CharelF01/CREPO2/Fotos/IMG_20220616_120403.jpg

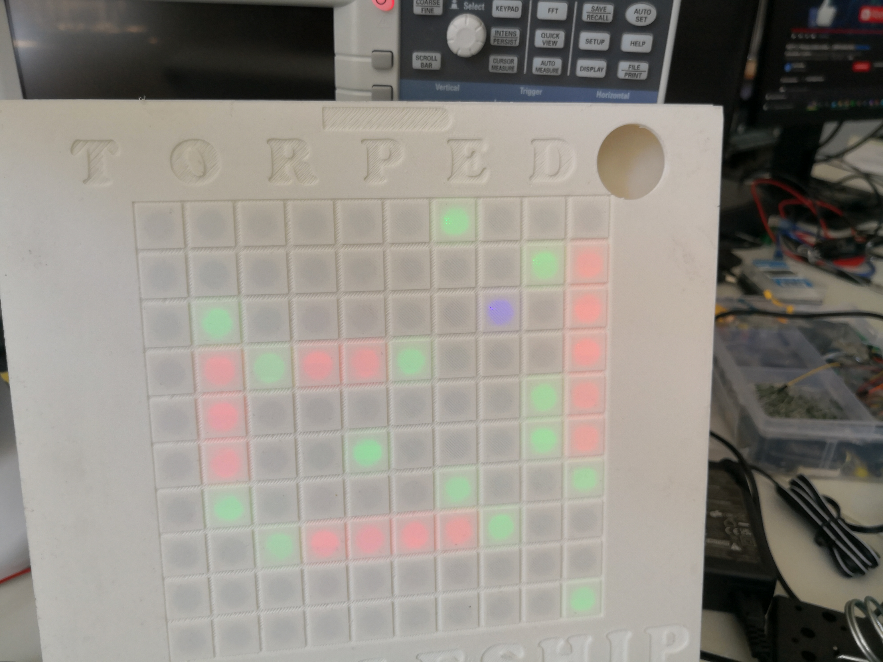
Fotos/IMG_20220616_120403.jpg
