CharelF01/CREPO2/README.md

# CREPO2
This project was done in the scope of the BTS-Internet of Things in the Lycée des Arts et Métiers Luxembourg
The Creative Project 2's objective was to smartify a boardgame, I chose Battleship

Mark received on Project: 14.6/20
