CharelF01/CREPO2/Documentation/Render.JPG

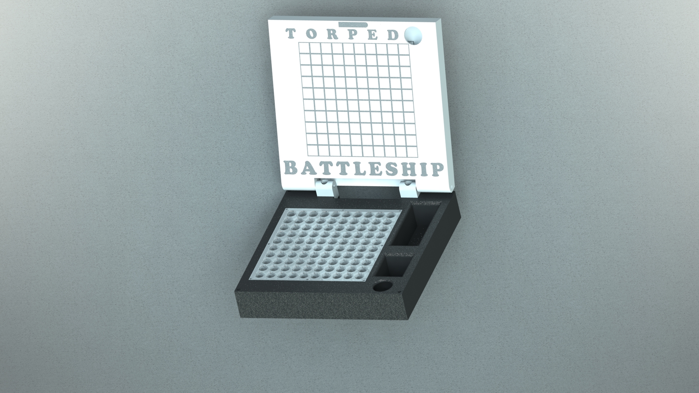
Documentation/Render.JPG
