CharelF01/CREPO2/Fotos/IMG_20220614_172337.jpg

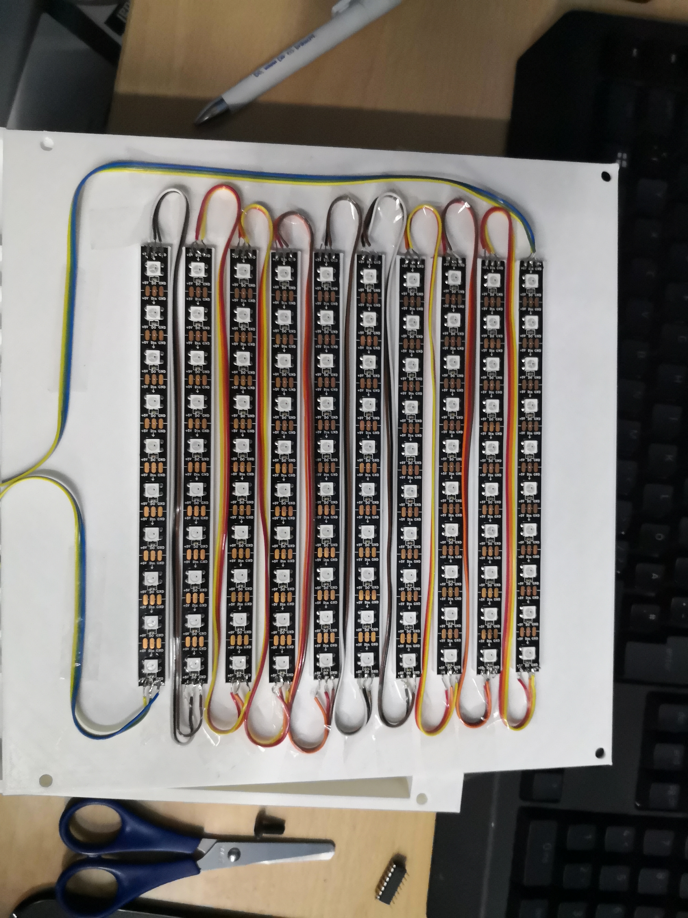
Fotos/IMG_20220614_172337.jpg
