CharelF01/CREPO2/Fotos/IMG_20220614_172339.jpg

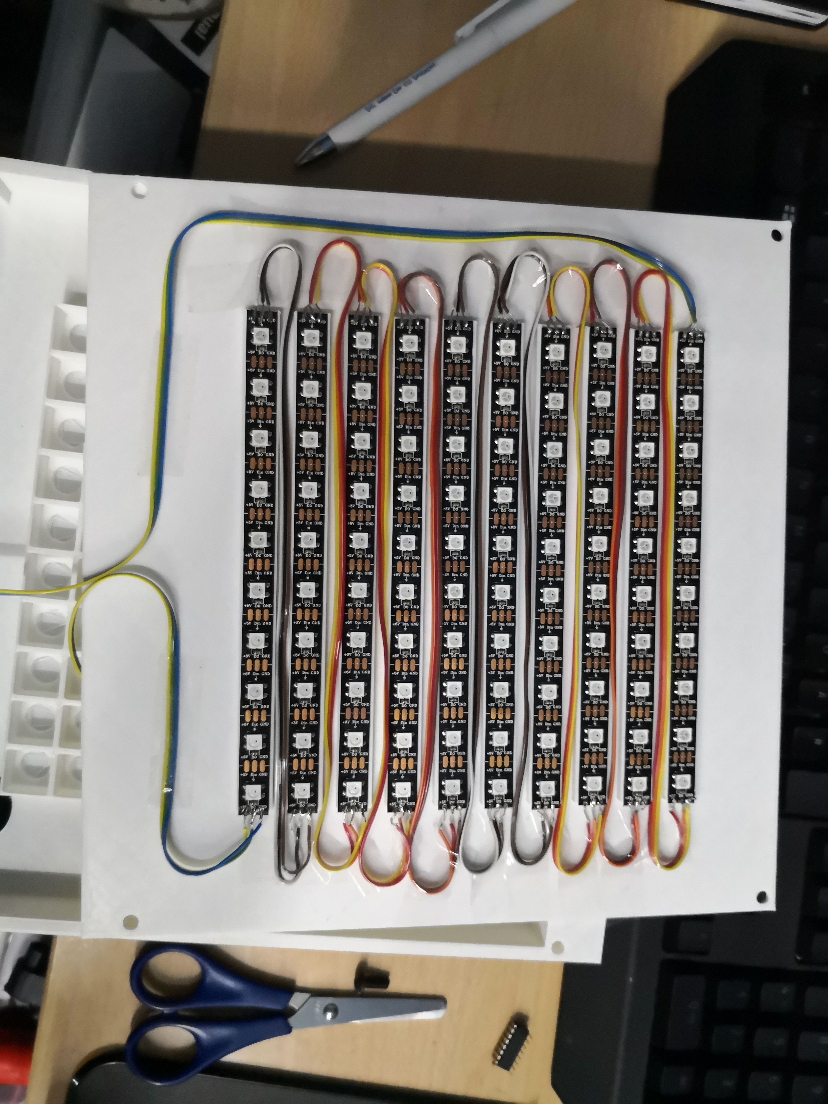
Fotos/IMG_20220614_172339.jpg
