CharelF01/CREPO2/Fotos/IMG_20220615_181046.jpg

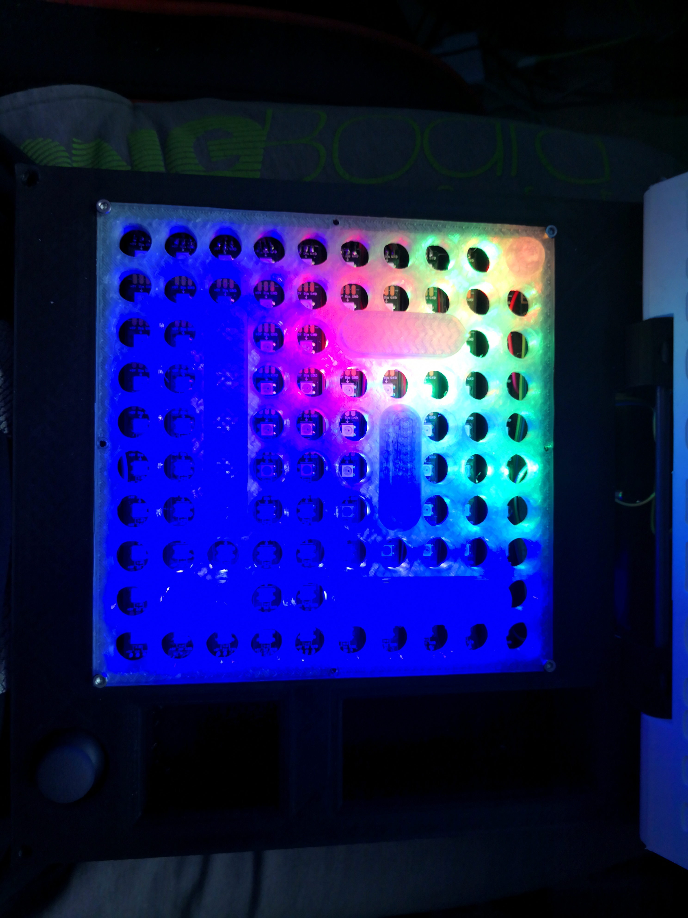
Fotos/IMG_20220615_181046.jpg
