CharelF01/CREPO2/Fotos/IMG_20220621_085531.jpg

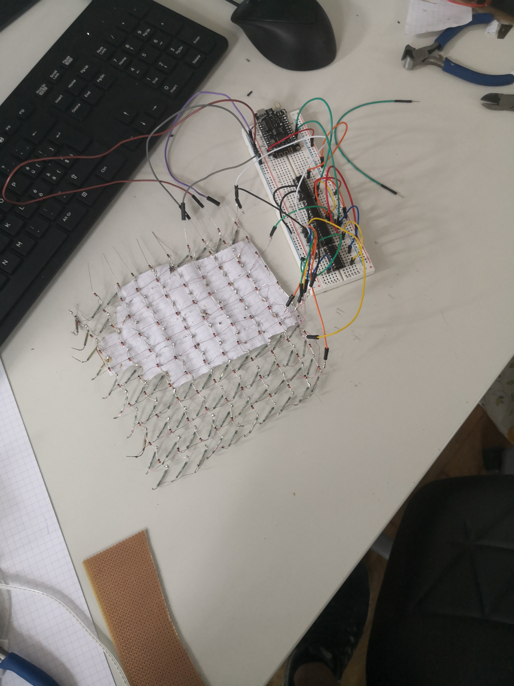
Fotos/IMG_20220621_085531.jpg
