CharelF01/CREPO2/Fotos/IMG_20220621_105107.jpg

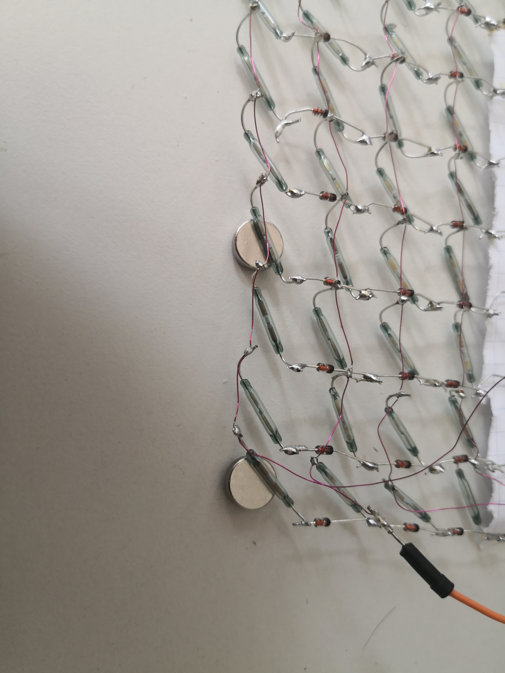
Fotos/IMG_20220621_105107.jpg
