CharelF01/CREPO2/Fotos/IMG_20220623_173132.jpg

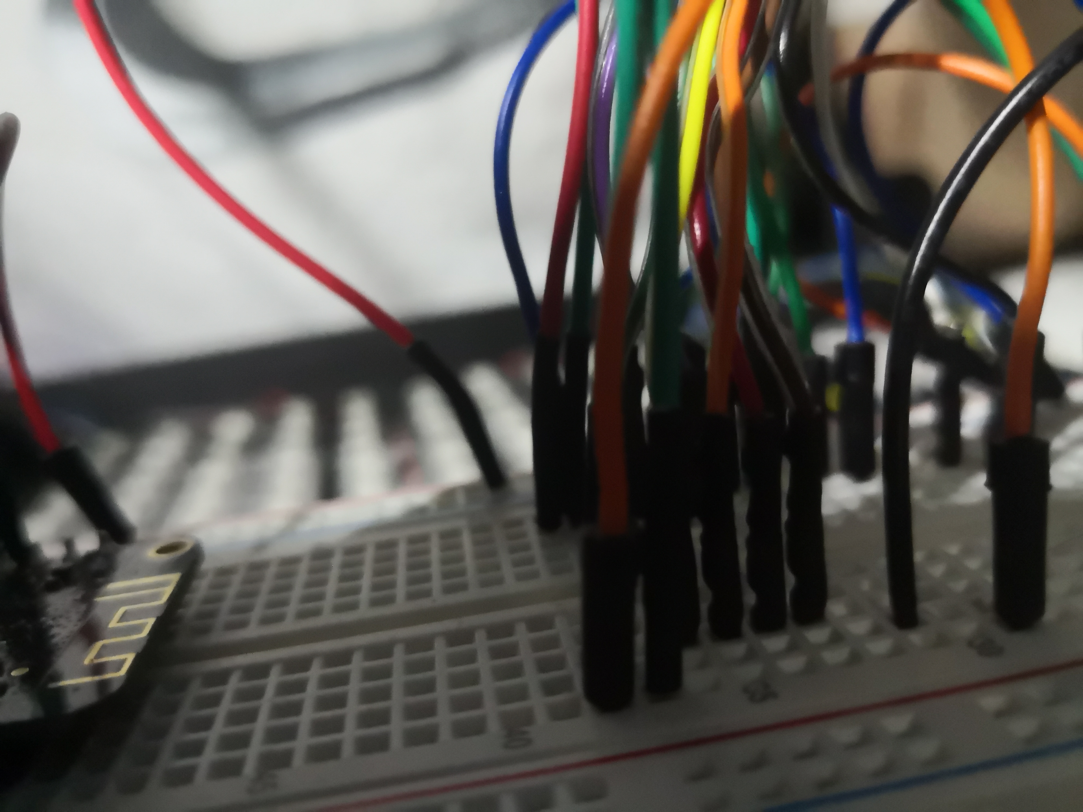
Fotos/IMG_20220623_173132.jpg
