CharelF01/CREPO2/Fotos/IMG_20220624_112900.jpg

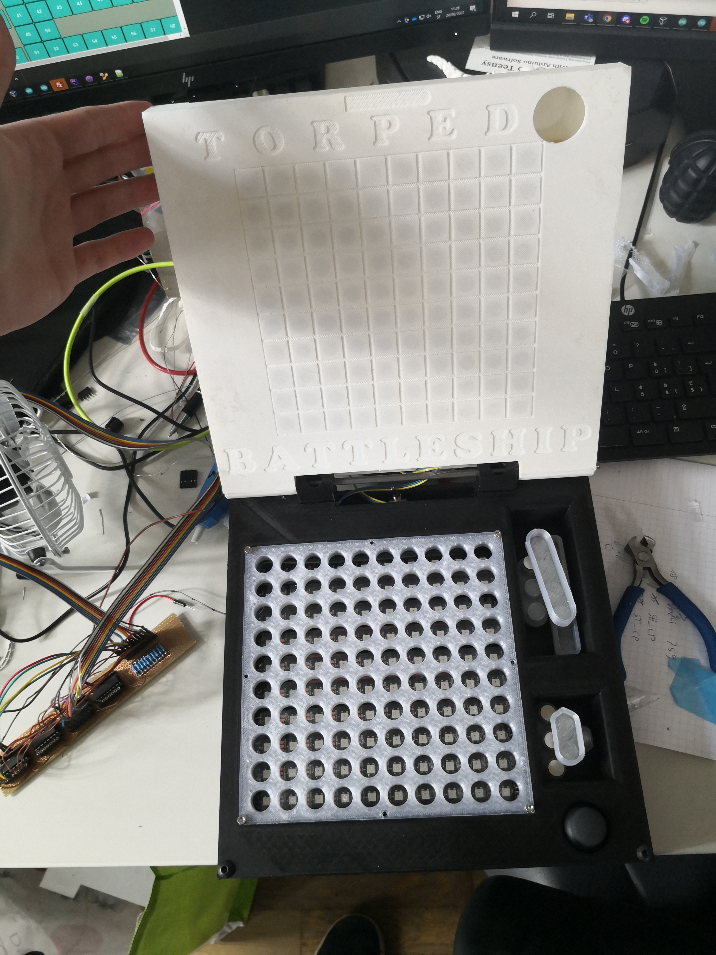
Fotos/IMG_20220624_112900.jpg
