CharelF01/CREPO2/Fotos/IMG_20220624_112909.jpg

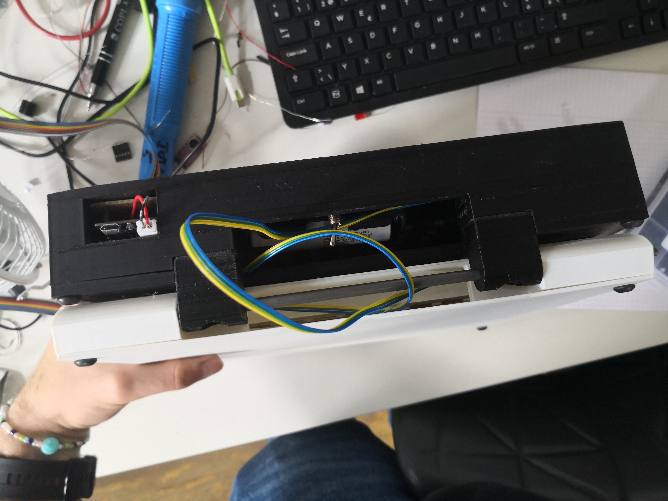
Fotos/IMG_20220624_112909.jpg
