CharelF01/CREPO2/Fotos/IMG_20220624_112915.jpg

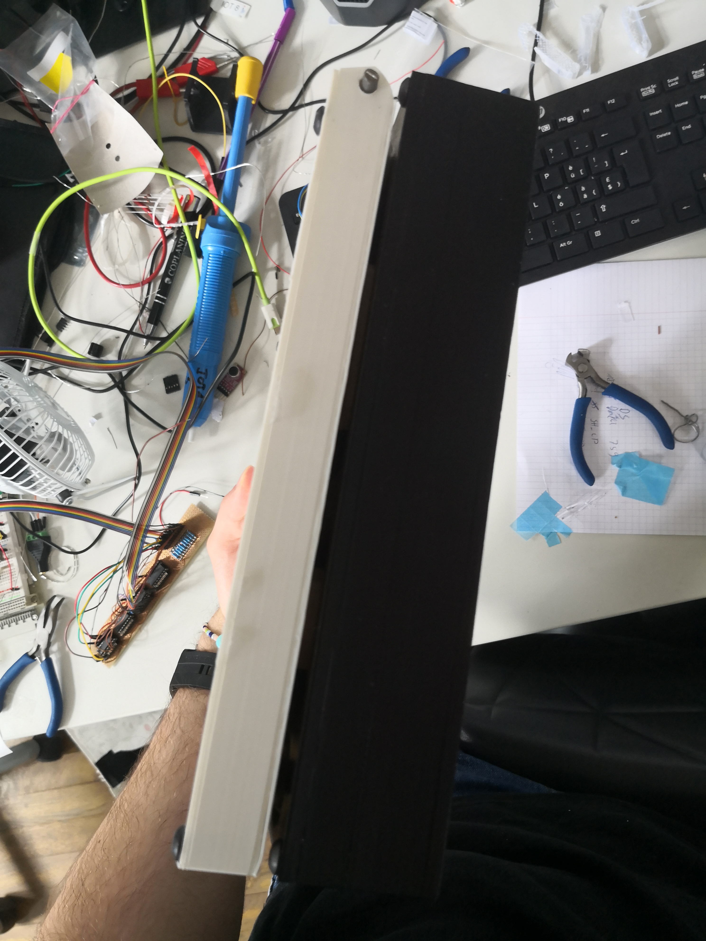
Fotos/IMG_20220624_112915.jpg
