CharelF01/CREPO2/Solidworks/Baugr1.SLDASM

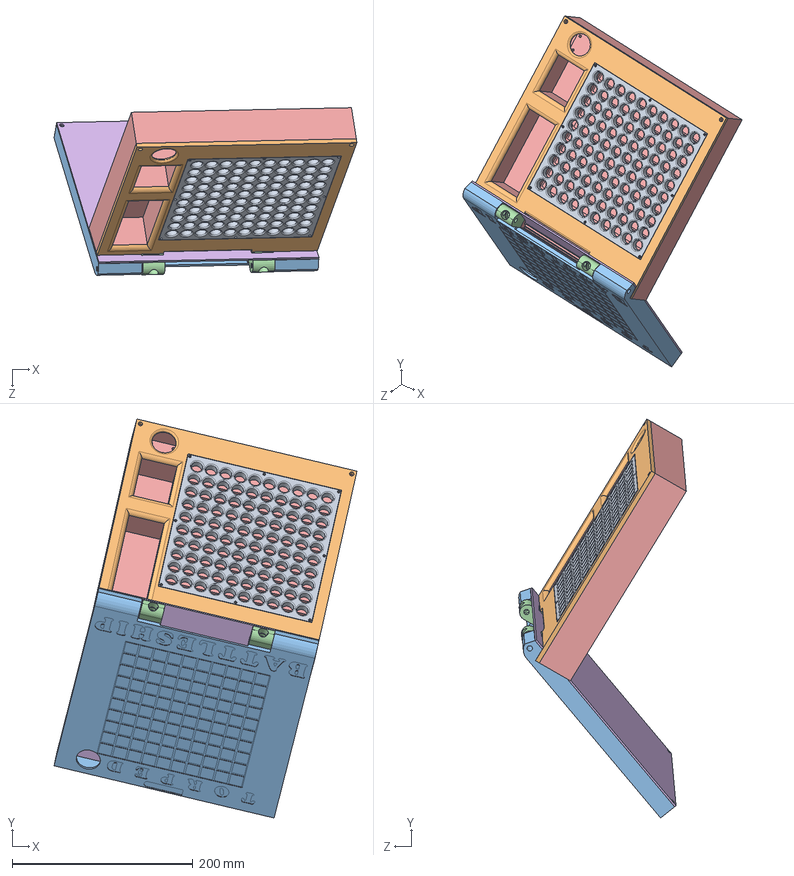
[picture p43: CAD file, 2023-04-04]
Solidworks/Baugr1.SLDASM
334.8 x 441.0 x 185.3 mm
Bottom (1)
top (1)
Scharnier x 2
BottomLowerPart
BottomHoles
topCover
