CharelF01/CREPO2/Solidworks/BottomHoles.SLDPRT

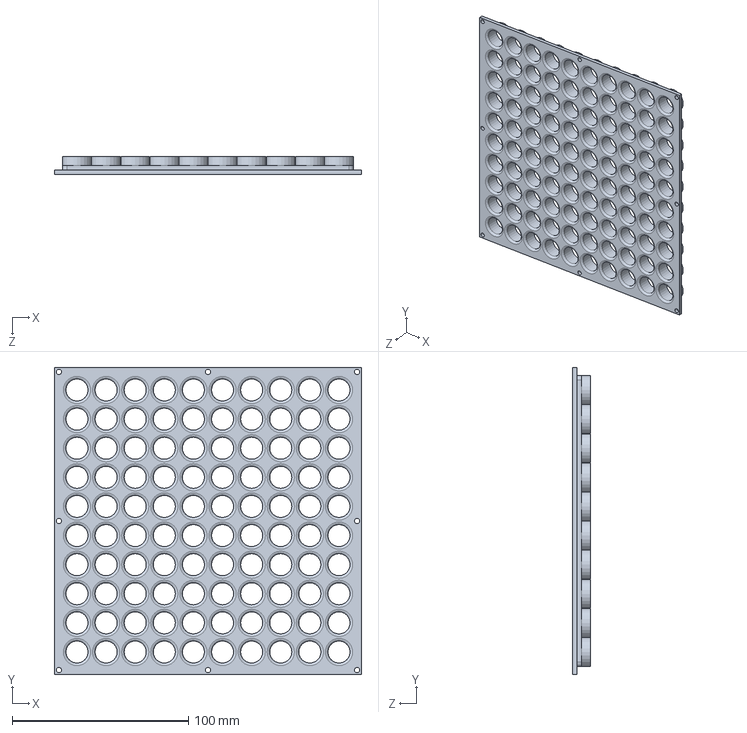
[picture p44: CAD file, 2023-04-04]
Solidworks/BottomHoles.SLDPRT
174.0 x 174.0 x 10.0 mm
