CharelF01/CREPO2/Solidworks/Ships/Battleship.SLDPRT

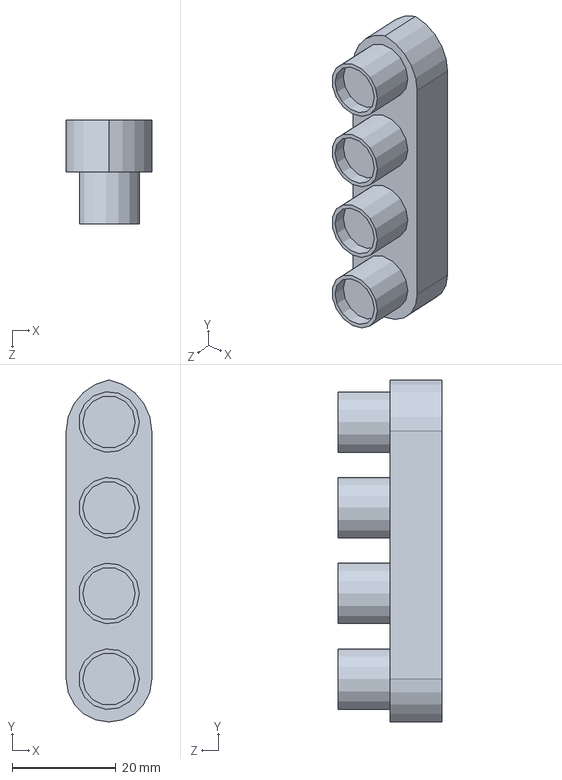
[picture p45: CAD file, 2023-04-04]
Solidworks/Ships/Battleship.SLDPRT
16.5 x 65.8 x 20.0 mm
