CharelF01/CREPO2/Solidworks/Ships/Submarine.SLDPRT

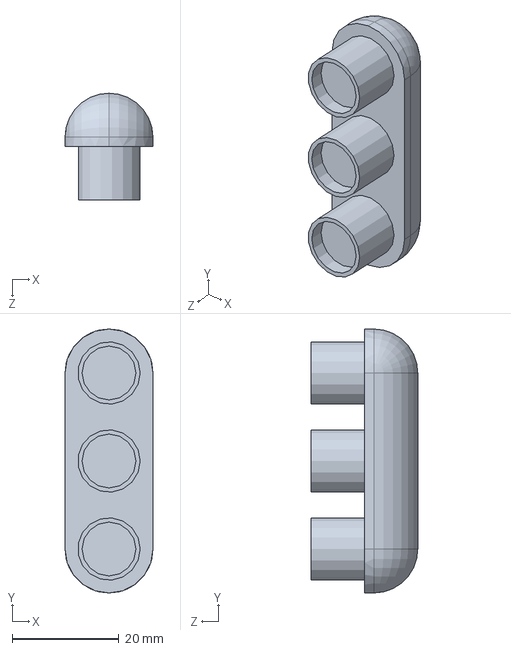
[picture p46: CAD file, 2023-04-04]
Solidworks/Ships/Submarine.SLDPRT
16.5 x 49.5 x 20.0 mm
