CharelF01/CREPO2/Solidworks/top (1).SLDPRT

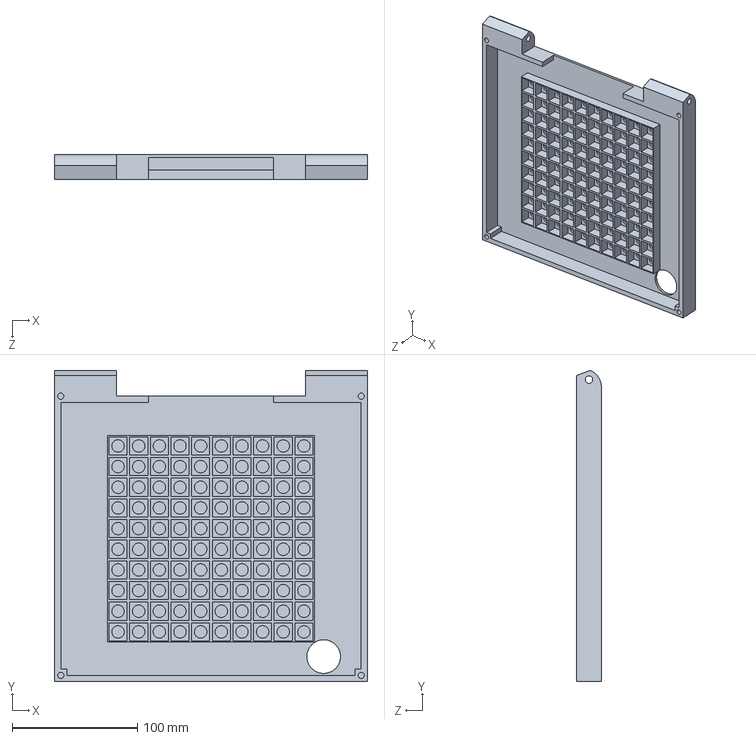
[picture p47: CAD file, 2023-04-04]
Solidworks/top (1).SLDPRT
250.0 x 248.6 x 20.0 mm
