CharelF01/CREPO2/Solidworks/BottomLowerPart.SLDPRT

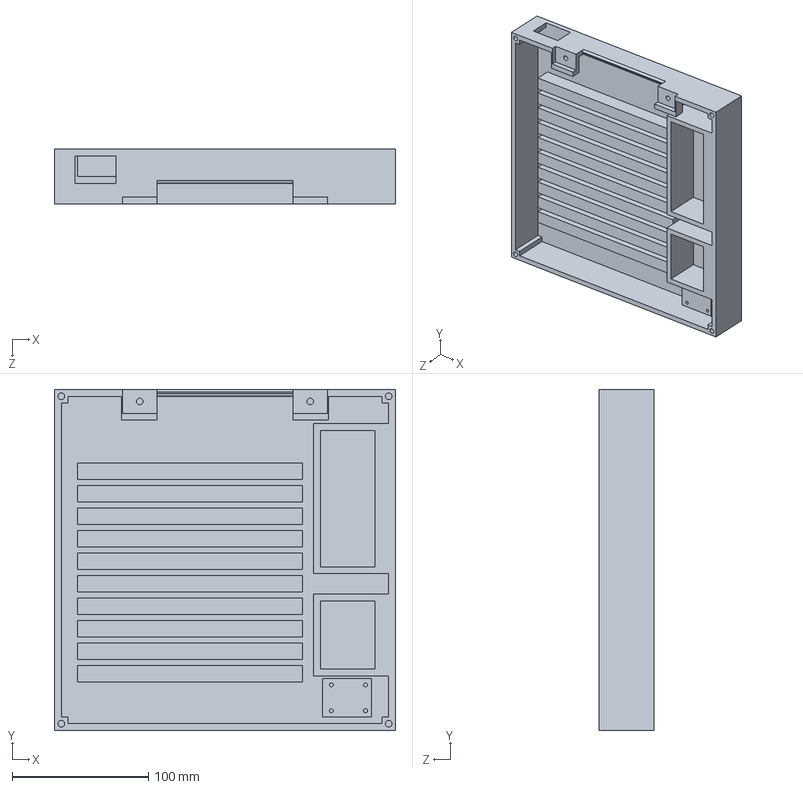
[picture p48: CAD file, 2023-04-04]
Solidworks/BottomLowerPart.SLDPRT
250.0 x 250.0 x 40.0 mm
