CharelF01/CREPO2/Solidworks/Ships/Destroyer.SLDPRT

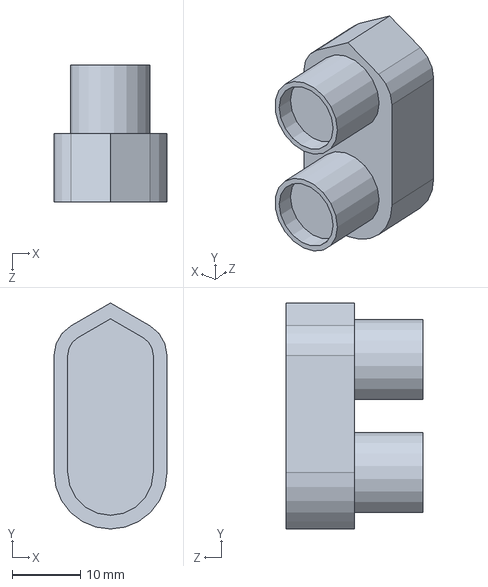
[picture p49: CAD file, 2023-04-04]
Solidworks/Ships/Destroyer.SLDPRT
16.5 x 33.0 x 20.0 mm
