CharelF01/CREPO2/Solidworks/Ships/Dapp.SLDPRT

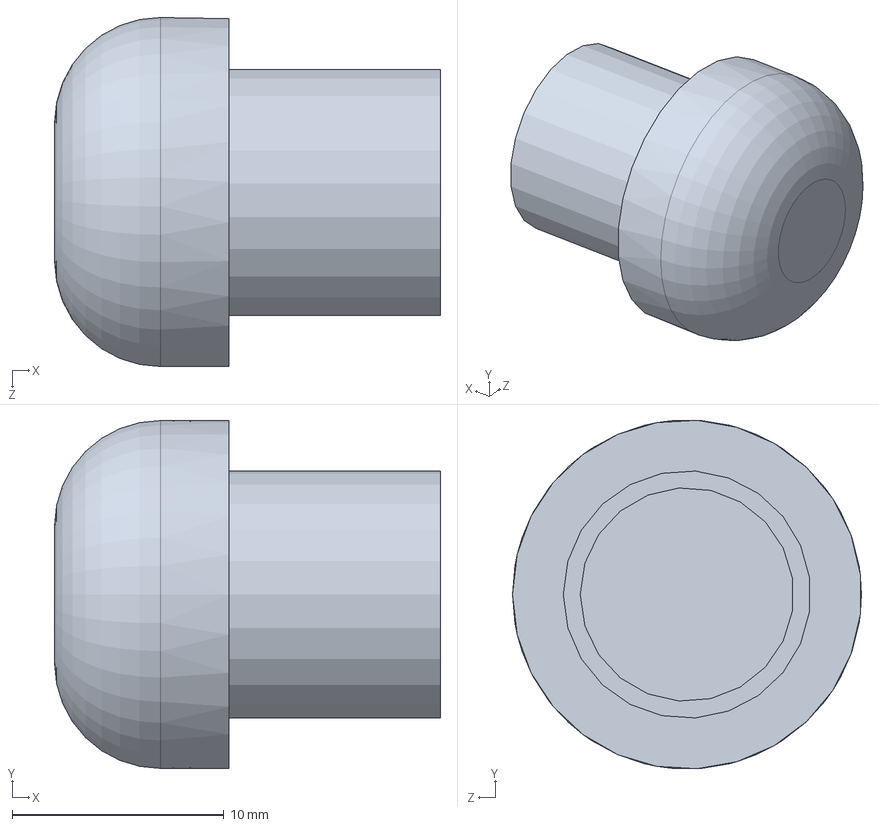
[picture p50: CAD file, 2023-04-04]
Solidworks/Ships/Dapp.SLDPRT
18.2 x 16.5 x 16.5 mm
