CharelF01/CREPO2/Solidworks/Ships/AirCarrier.SLDPRT

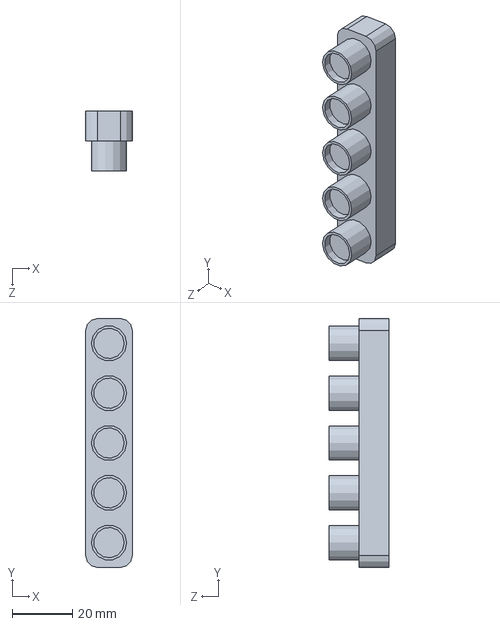
[picture p51: CAD file, 2023-04-04]
Solidworks/Ships/AirCarrier.SLDPRT
15.5 x 82.5 x 20.0 mm
