CharelF01/CREPO2/Solidworks/topCover.SLDPRT

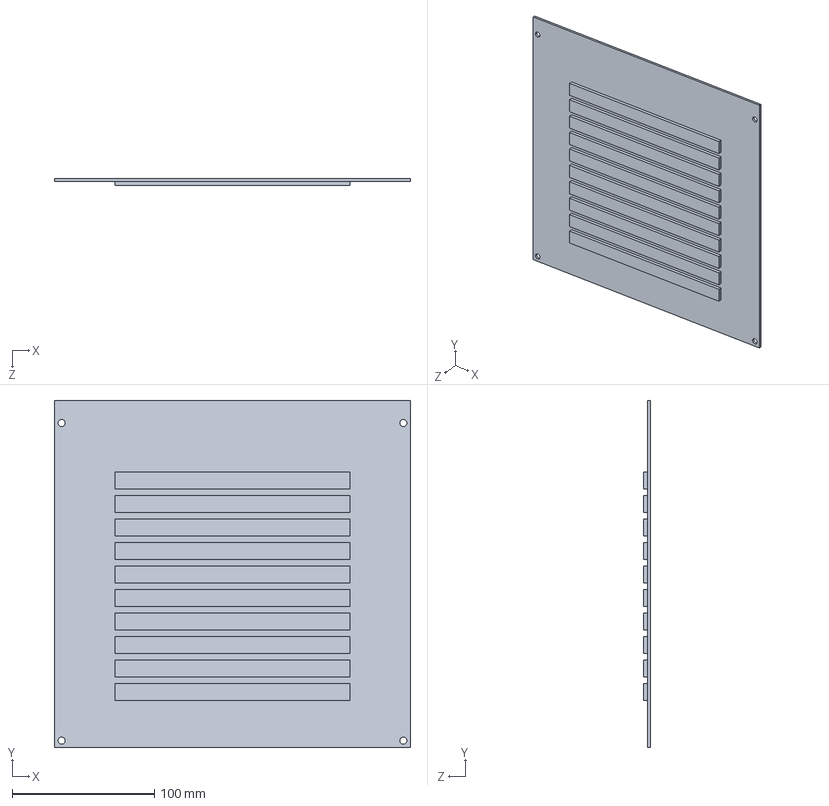
[picture p52: CAD file, 2023-04-04]
Solidworks/topCover.SLDPRT
250.0 x 244.0 x 5.00 mm
