CharelF01/CREPO2/Solidworks/Bottom (1).SLDPRT

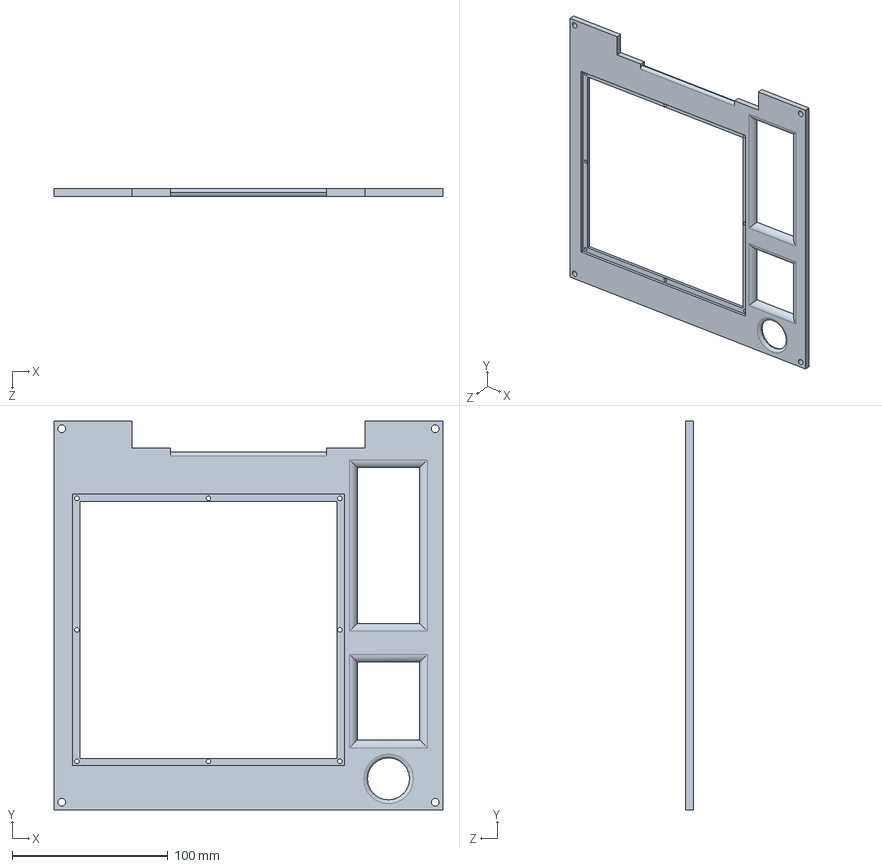
[picture p53: CAD file, 2023-04-04]
Solidworks/Bottom (1).SLDPRT
250.0 x 250.0 x 5.00 mm
