CharelF01/CREPO2/Solidworks/Ships/Cruiser.SLDPRT

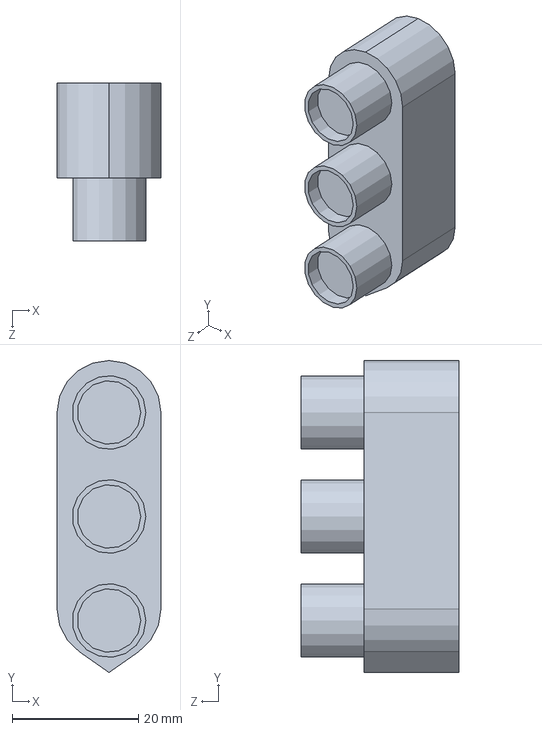
[picture p54: CAD file, 2023-04-04]
Solidworks/Ships/Cruiser.SLDPRT
16.5 x 49.5 x 25.0 mm
